QUTstevenbulmer/Unit_EGH455/PCB/USBC_AVR_LCD/USBC_AVR_LCD.kicad_pcb

## KiCad design PCB/USBC_AVR_LCD/USBC_AVR_LCD.kicad_pcb (2026-11-11)

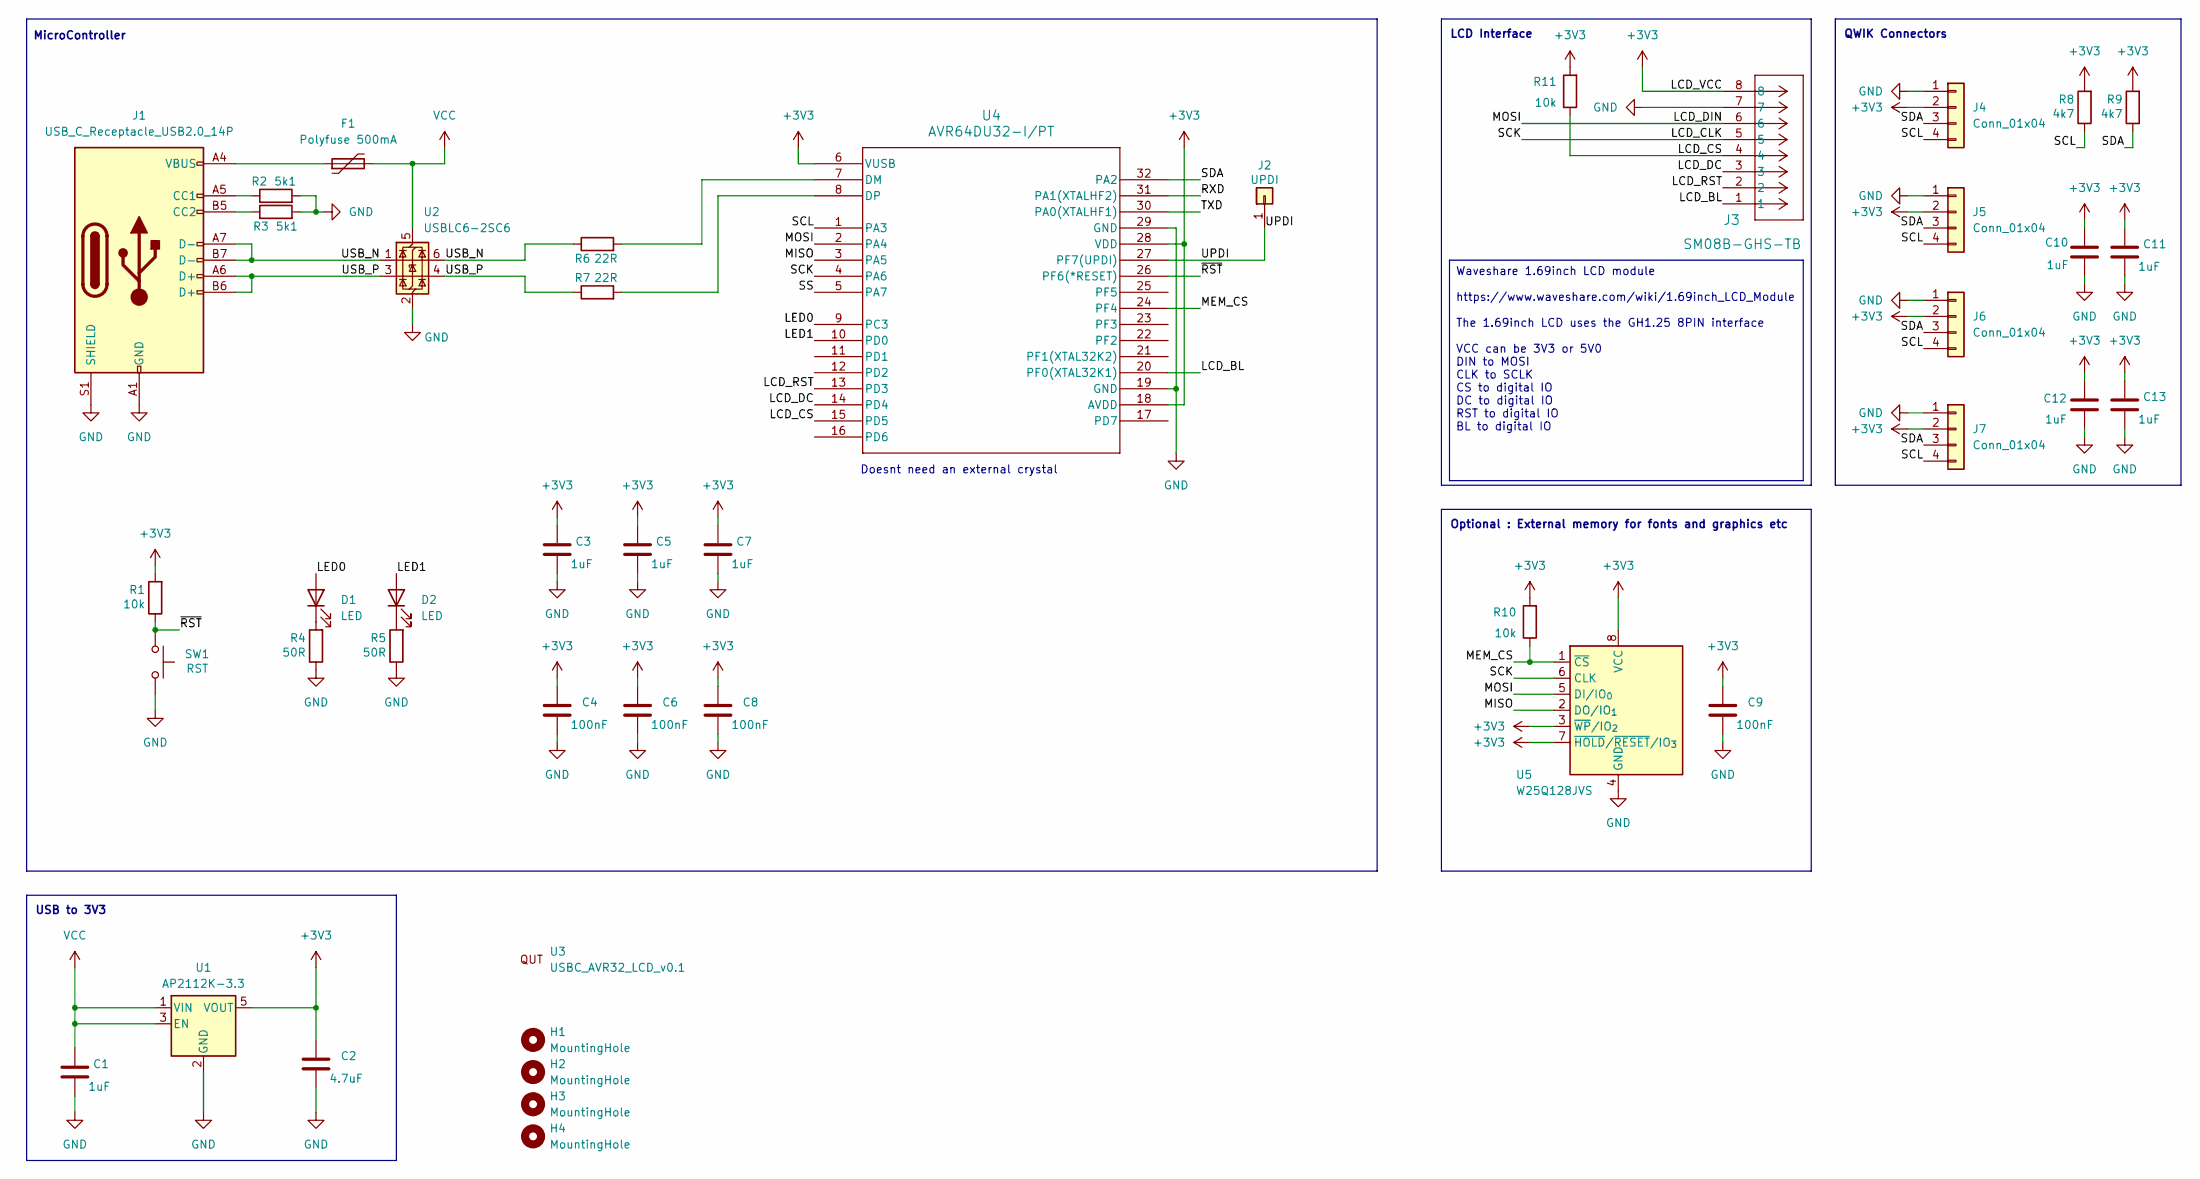
[picture p1: schematic USBC_AVR_LCD.kicad_sch]

Parts:
C1, C3, C5, C7, C10, C11, C12, C13: 1uF; C_0402_1005Metric_Pad0.74x0.62mm_HandSolder
C2: 4.7uF; C_0402_1005Metric_Pad0.74x0.62mm_HandSolder
C4, C6, C8, C9: 100nF; C_0402_1005Metric_Pad0.74x0.62mm_HandSolder
D1, D2: LED; LED_0603_1608Metric_Pad1.05x0.95mm_HandSolder
F1: Polyfuse 500mA; Fuse_0805_2012Metric_Pad1.15x1.40mm_HandSolder
H1, H2, H3, H4: MountingHole; MountingHole_2.2mm_M2
J1: USB_C_Receptacle_USB2.0_14P; USB_C_Receptacle_HRO_TYPE-C-31-M-12
J2: UPDI; PinHeader_1x01_P2.54mm_Vertical
J3: SM08B-GHS-TB; JST_GH_SM08B-GHS-TB_1x08-1MP_P1.25mm_Horizontal
J4, J5, J6, J7: Conn_01x04; JST_SH_SM04B-SRSS-TB_1x04-1MP_P1.00mm_Horizontal
R1, R10, R11: 10k; R_0402_1005Metric_Pad0.72x0.64mm_HandSolder
R2, R3: 5k1; R_0402_1005Metric_Pad0.72x0.64mm_HandSolder
R4, R5: 50R; R_0402_1005Metric_Pad0.72x0.64mm_HandSolder
R6, R7: 22R; R_0402_1005Metric_Pad0.72x0.64mm_HandSolder
R8, R9: 4k7; R_0402_1005Metric_Pad0.72x0.64mm_HandSolder
SW1: RST; Switch SMD STO
U1: AP2112K-3.3; SOT-23-5
U2: USBLC6-2SC6; SOT-23-6
U3: USBC_AVR32_LCD_v0.1; logo_QUT
U4: AVR64DU32-I/PT; TQFP32_PT_MCH
U5: W25Q128JVS; SOIC-8_5.3x5.3mm_P1.27mm

Connections:
+3V3: C2.1, C3.1, C4.1, C5.1, C6.1, C7.1, C8.1, C9.1, C10.1, C11.1, C12.1, C13.1, J3.8, J4.2, J5.2, J6.2, J7.2, R1.2, R8.2, R9.2, R10.2, R11.2, U1.5 (VOUT), U4.6 (VUSB), U4.18 (AVDD), U4.28 (VDD), U5.3 (~WP/IO_{2}), U5.7 (~HOLD/~RESET/IO_{3}), U5.8 (VCC)
/LCD_BL: J3.1, U4.20 (PF0(XTAL32K1))
/LCD_CLK: J3.5, U4.4 (PA6), U5.6 (CLK)
/LCD_CS: J3.4, R11.1, U4.15 (PD5)
/LCD_DC: J3.3, U4.14 (PD4)
/LCD_DIN: J3.6, U4.2 (PA4), U5.5 (DI/IO_{0})
/LCD_RST: J3.2, U4.13 (PD3)
/LED0: D1.2 (A), U4.9 (PC3)
/LED1: D2.2 (A), U4.10 (PD0)
/MEM_CS: R10.1, U4.24 (PF4), U5.1 (~CS)
/MISO: U4.3 (PA5), U5.2 (DO/IO_{1})
/RXD: U4.31 (PA1(XTALHF2))
/SCL: J4.4, J5.4, J6.4, J7.4, R8.1, U4.1 (PA3)
/SDA: J4.3, J5.3, J6.3, J7.3, R9.1, U4.32 (PA2)
/SS: U4.5 (PA7)
/TXD: U4.30 (PA0(XTALHF1))
/UPDI: J2.1 (Pin_1_1), U4.27 (PF7(UPDI))
/USB_N: J1.A7 (D-), J1.B7 (D-), R6.1, U2.1 (I/O1), U2.6 (I/O1)
/USB_P: J1.A6 (D+), J1.B6 (D+), R7.1, U2.3 (I/O2), U2.4 (I/O2)
/~RST: R1.1, SW1.1, U4.26 (PF6(*RESET))
GND: C1.2, C2.2, C3.2, C4.2, C5.2, C6.2, C7.2, C8.2, C9.2, C10.2, C11.2, C12.2, C13.2, J1.A1 (GND), J1.A12 (GND), J1.B1 (GND), J1.B12 (GND), J1.S1 (SHIELD), J3.7, J4.1, J5.1, J6.1, J7.1, R2.2, R3.2, R4.1, R5.1, SW1.2, U1.2 (GND), U2.2 (GND), U4.19 (GND), U4.29 (GND), U5.4 (GND)
unnamed: D1.1 (K), R4.2
unnamed: D2.1 (K), R5.2
unnamed: F1.1, J1.A4 (VBUS), J1.A9 (VBUS), J1.B4 (VBUS), J1.B9 (VBUS)
unnamed: J1.A5 (CC1), R2.1
unnamed: J1.B5 (CC2), R3.1
unnamed: R6.2, U4.7 (DM)
unnamed: R7.2, U4.8 (DP)
VCC: C1.1, F1.2, U1.1 (VIN), U1.3 (EN), U2.5 (VBUS)

Notes on the sheet:
USB to 3V3
MicroController
Optional : External memory for fonts and graphics etc
LCD Interface
Doesnt need an external crystal
QWIK Connectors
Waveshare 1.69inch LCD module https://www.waveshare.com/wiki/1.69inch_LCD_Module The 1.69inch LCD uses the GH1.25 8PIN interface VCC can be 3V3 or 5V0 DIN to MOSI CLK to SCLK CS to digital IO DC to digital IO RST to digital IO BL to digital IO

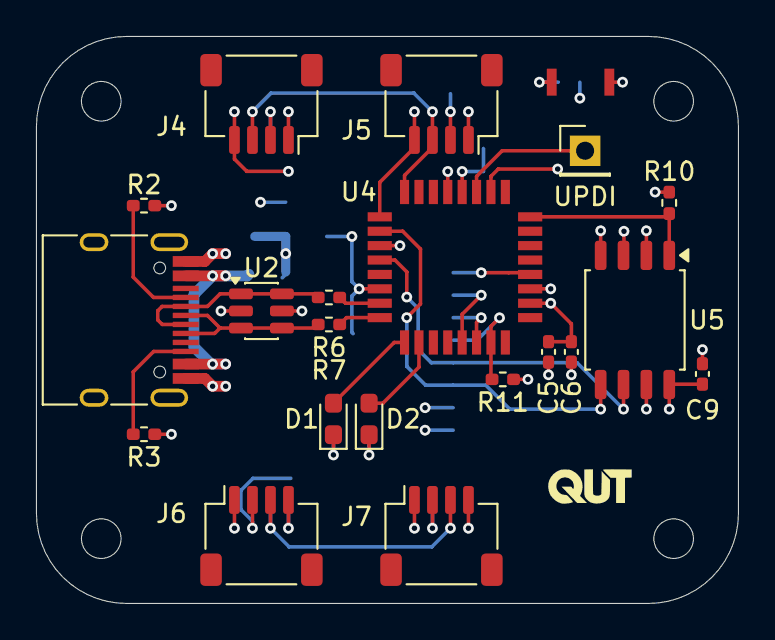
[picture p2: board USBC_AVR_LCD.kicad_pcb from above]

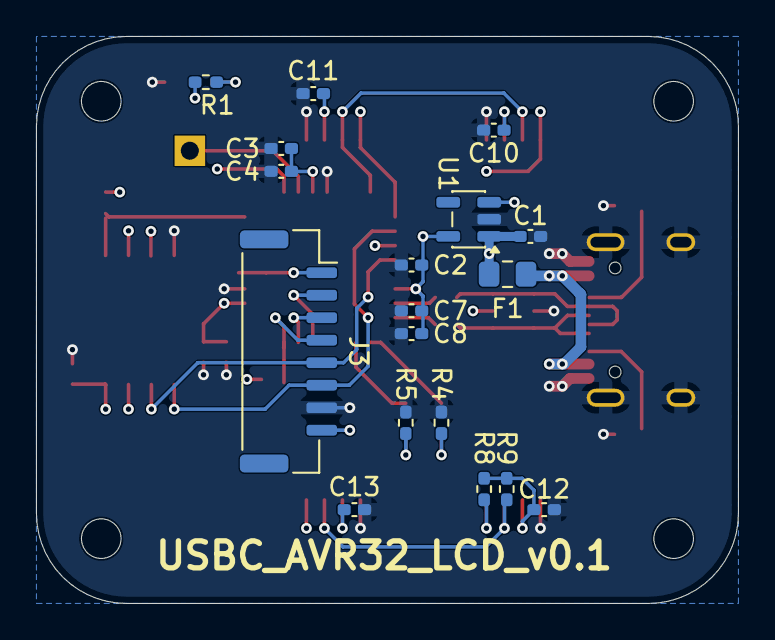
[picture p3: board USBC_AVR_LCD.kicad_pcb from below]

Board: 4 copper layers, 39.0 x 31.5 mm, 44 parts (18 on the bottom side), 26 nets.
